GIXLabs/macro_pad/cad/stencil_jig.stl

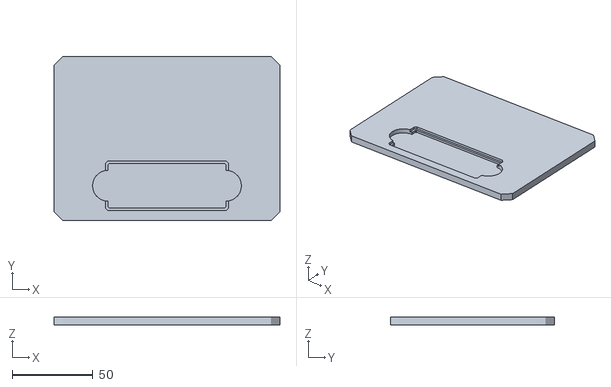
[picture p1: CAD file, 2022-10-25]
cad/stencil_jig.stl
139.7 x 101.6 x 4.76
