GIXLabs/macro_pad/cad/board_outline.dxf

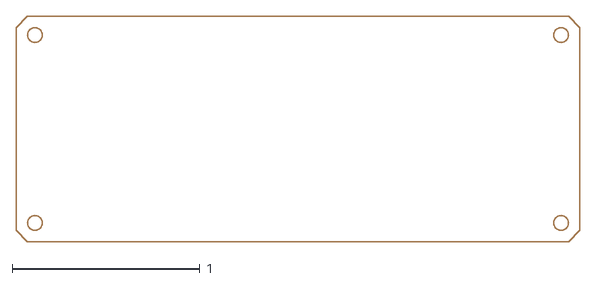
[picture p2: CAD file, 2022-10-25]
cad/board_outline.dxf
3.00 x 1.20
