GIXLabs/macro_pad/cad/base.stl

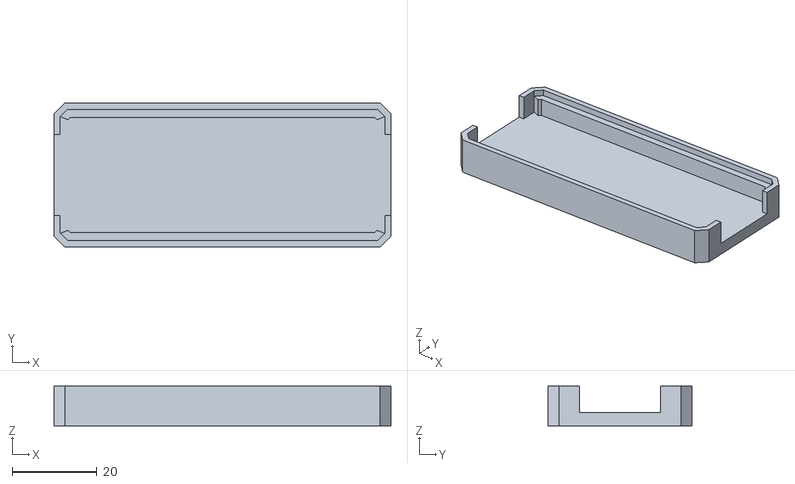
[picture p3: CAD file, 2022-10-25]
cad/base.stl
79.7 x 34.0 x 9.45
