GIXLabs/macro_pad/(list of files, cad)

Other CAD files:
cad/macro_pad.f3d
