GIXLabs/macro_pad/electronics/pico_pad.brd

## EAGLE design electronics/pico_pad.brd (2022-10-25)

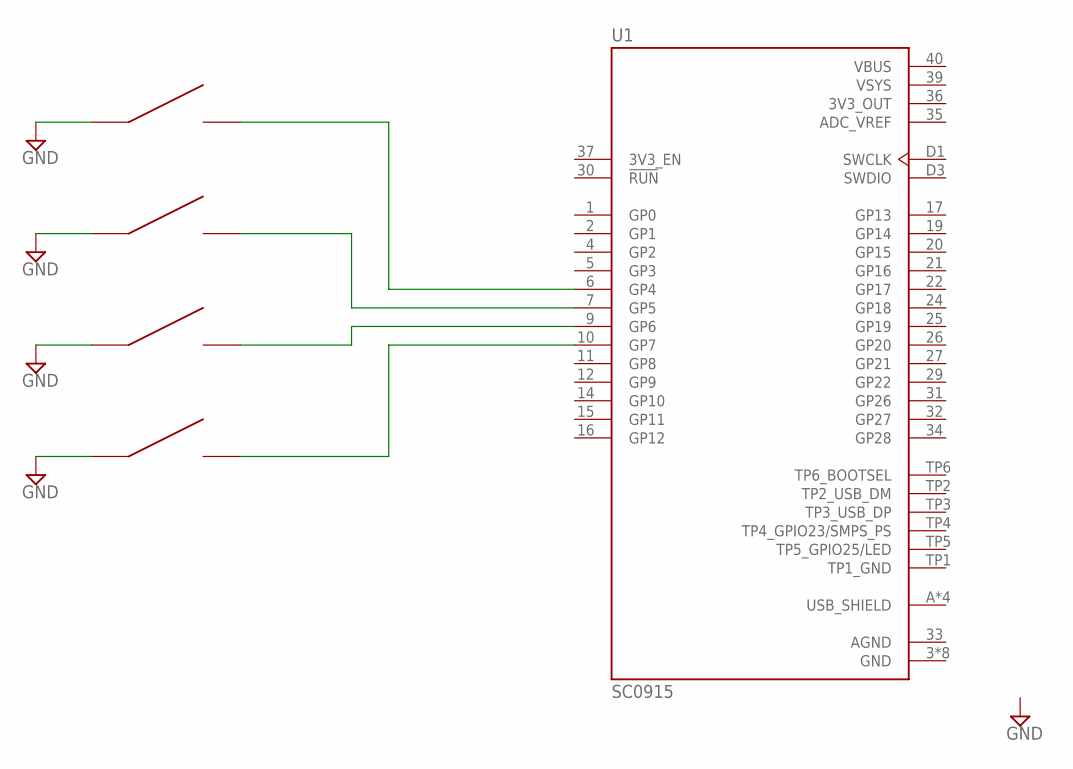
[picture p4: schematic pico_pad.sch]

Parts:
U1: SC0915; MODULE_SC0915
U$1, U$2, U$3, U$4: PTS526_TACT

Connections:
3V3_OUT: U1.36 (3V3_OUT)
ADC_VREF: U1.35 (ADC_VREF)
AGND: U1.33 (AGND)
GND: U1.3 (GND), U1.8 (GND), U1.13 (GND), U1.18 (GND), U1.23 (GND), U1.28 (GND), U1.38 (GND), U1.D2 (GND), U$1.A1 (A), U$1.A2 (A), U$2.A1 (A), U$2.A2 (A), U$3.A1 (A), U$3.A2 (A), U$4.A1 (A), U$4.A2 (A)
unnamed: U1.6 (GP4), U$2.B1 (B), U$2.B2 (B)
unnamed: U1.7 (GP5), U$3.B1 (B), U$3.B2 (B)
unnamed: U1.9 (GP6), U$1.B1 (B), U$1.B2 (B)
unnamed: U1.10 (GP7), U$4.B1 (B), U$4.B2 (B)
TP1_GND: U1.TP1 (TP1_GND)
USB_SHIELD: U1.A (USB_SHIELD), U1.B (USB_SHIELD), U1.C (USB_SHIELD), U1.D (USB_SHIELD)
VBUS: U1.40 (VBUS)
VSYS: U1.39 (VSYS)

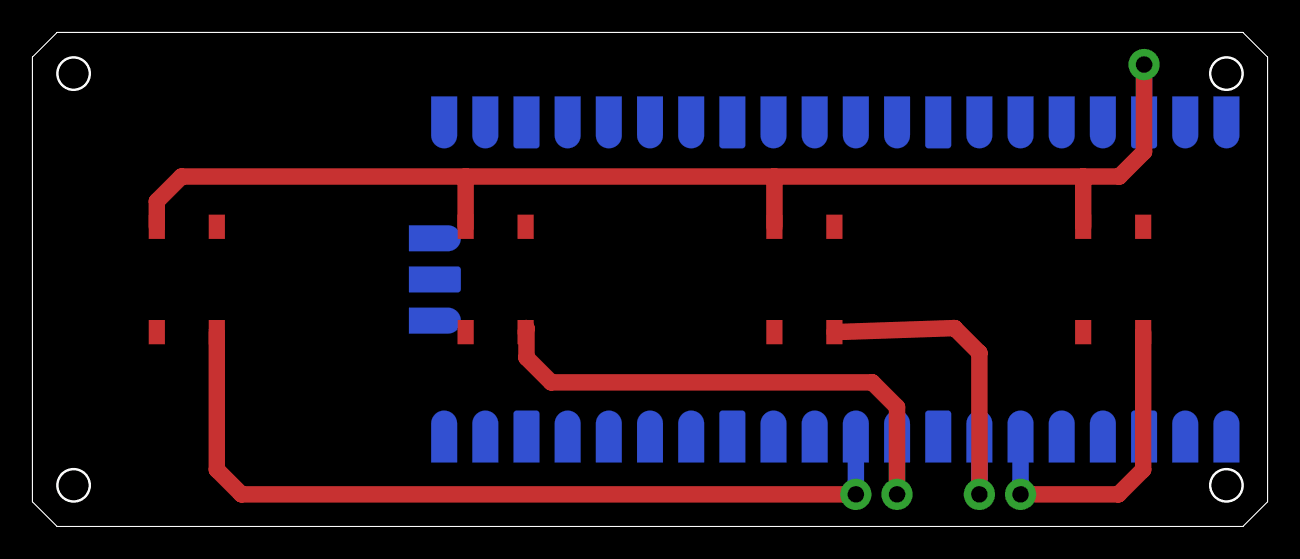
[picture p5: board pico_pad.brd from above]

Board: 2 copper layers, 76.2 x 30.5 mm, 5 parts (1 on the bottom side), 6 nets.
